oeps-tech/peripheral.harp-to-onix/Assets/harp timestmap bus to SMA.jpg

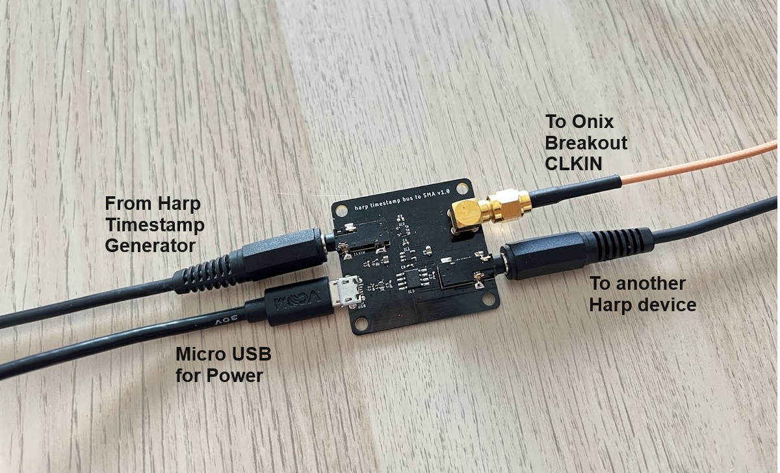
Assets/harp timestmap bus to SMA.jpg
