oeps-tech/peripheral.harp-to-onix/harp to ONIX converter BOM.xlsx

OEPS PN | Schematic Name | Qtty. | Description | Type | Manufacturer PN | Supplier | Supplier PN | Notes
OEPS020019 | R2 | 1 | RESISTOR: SMD 0402 100kΩ ±1% 0.100W [ERJ-2RKF1003X] [SMD] | SMD | ERJ-2RKF1003X | DigiKey | P100KLDKR-ND
OEPS010016 | C2, C3, C6, C7, C8 | 5 | CAPACITOR: SMD CER 0402 100nF 50V ±10% X7R [CGA2B3X7R1H104K050BB] [SMD] | SMD | CGA2B3X7R1H104K050BB | DigiKey | 445-6899-6-ND
OEPS010015 | C4, C5 | 2 | CAPACITOR: SMD CER 0603 10uF 16V ±20% X5R [EMK107BBJ106MA-T] [SMD] | SMD | EMK107BBJ106MA-T | DigiKey | 587-3238-6-ND
OEPS020026 | R1 | 1 | RESISTOR: SMD 0402 1MΩ ±1% 0.063W [CRCW04021M00FKED] [SMD] | SMD | CRCW04021M00FKED | DigiKey | 541-1.00MLDKR-ND
OEPS010017 | C1 | 1 | CAPACITOR: SMD CER 0402 4.7nF 100V ±10% X7R [885012205084] [SMD] | SMD | 885012205084 | DigiKey | 732-12234-6-ND
OEPS040003 | L1 | 1 | INDUCTOR: FERRITE BEAD SMD 40Ω 2A 50mΩ [MI0805K400R-10] [0805] | SMD | MI0805K400R-10 | DigiKey | 240-2389-6-ND
OEPS070061 | X1 | 1 | CONNECTOR: SMA JACK 50ohm R/A [PCB.SMAFRA.HT] [TH] | TH | PCB.SMAFRA.HT | DigiKey | 931-1361-ND
OEPS070025 | CLKIN, CLKOUT | 2 | CONNECTOR: 3.5MM JACK STEREO 90º [35RASMT2BHNTRX] [SMD] | SMD | 35RASMT2BHNTRX | DigiKey | SC1489-6-ND
OEPS080016 | IC1 | 1 | IC: LDO 3.3V 250mA [LP5907MFX-3.3/NOPB] [SOT-23-5] | SMD | LP5907MFX-3.3/NOPB | DigiKey | 296-38557-6-ND
OEPS080030 | IC3 | 1 | IC: DIGITAL ISOLATOR 1WAY [SI8610EC-B-ISR] [8-SOIC] | SMD | SI8610EC-B-ISR | DigiKey | 336-4930-6-ND
OEPS080029 | IC2 | 1 | IC: BUFFER NON-INVERT 1CH 3-STATE [SN74LVC1G125DBVT] [SOT-23-5] | SMD | SN74LVC1G125DBVT | DigiKey | 296-26595-6-ND
OEPS070062 | USB | 1 | CONNECTOR: USB 2.0 MICRO B R/A [ZX62D-B-5P8(30)] [SMD/TH] | SMD/TH | ZX62D-B-5P8(30) | DigiKey | H125272DKR-ND
