oeps-tech/peripheral.harp-to-onix/harp to ONIX converter PCB.pdf

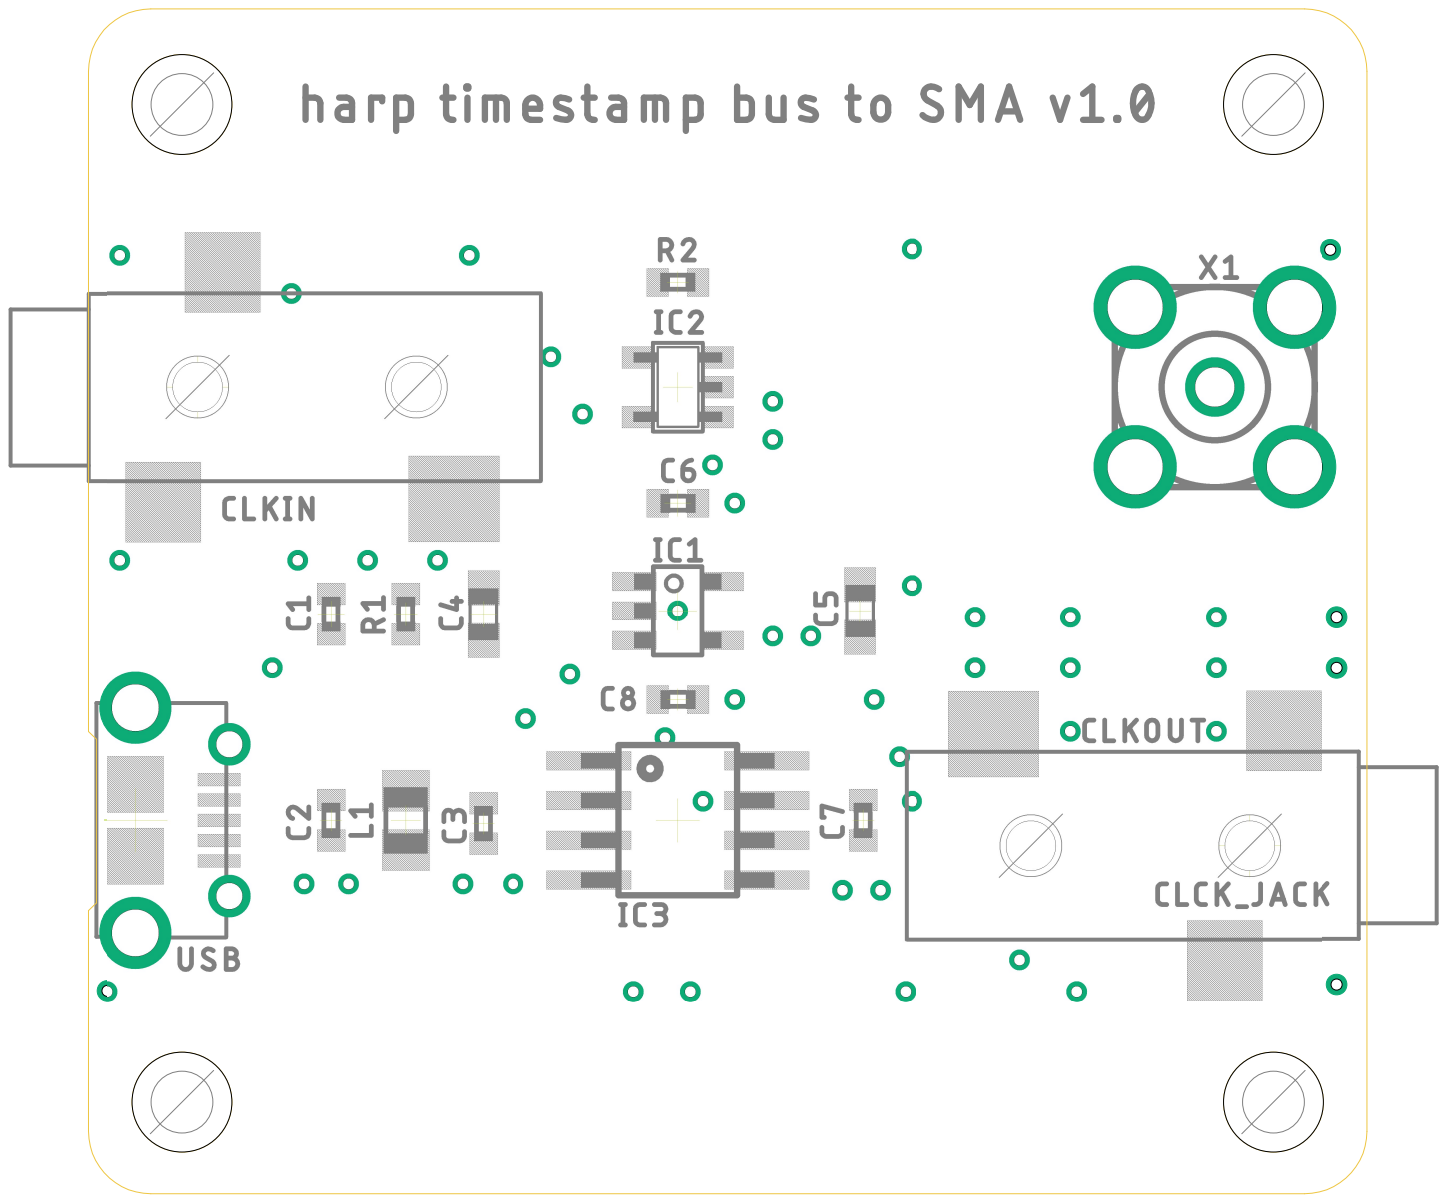
[picture p2: page 1]
