oeps-tech/peripheral.harp-to-onix/harp to ONIX converter Sch.pdf

# 1USB

A

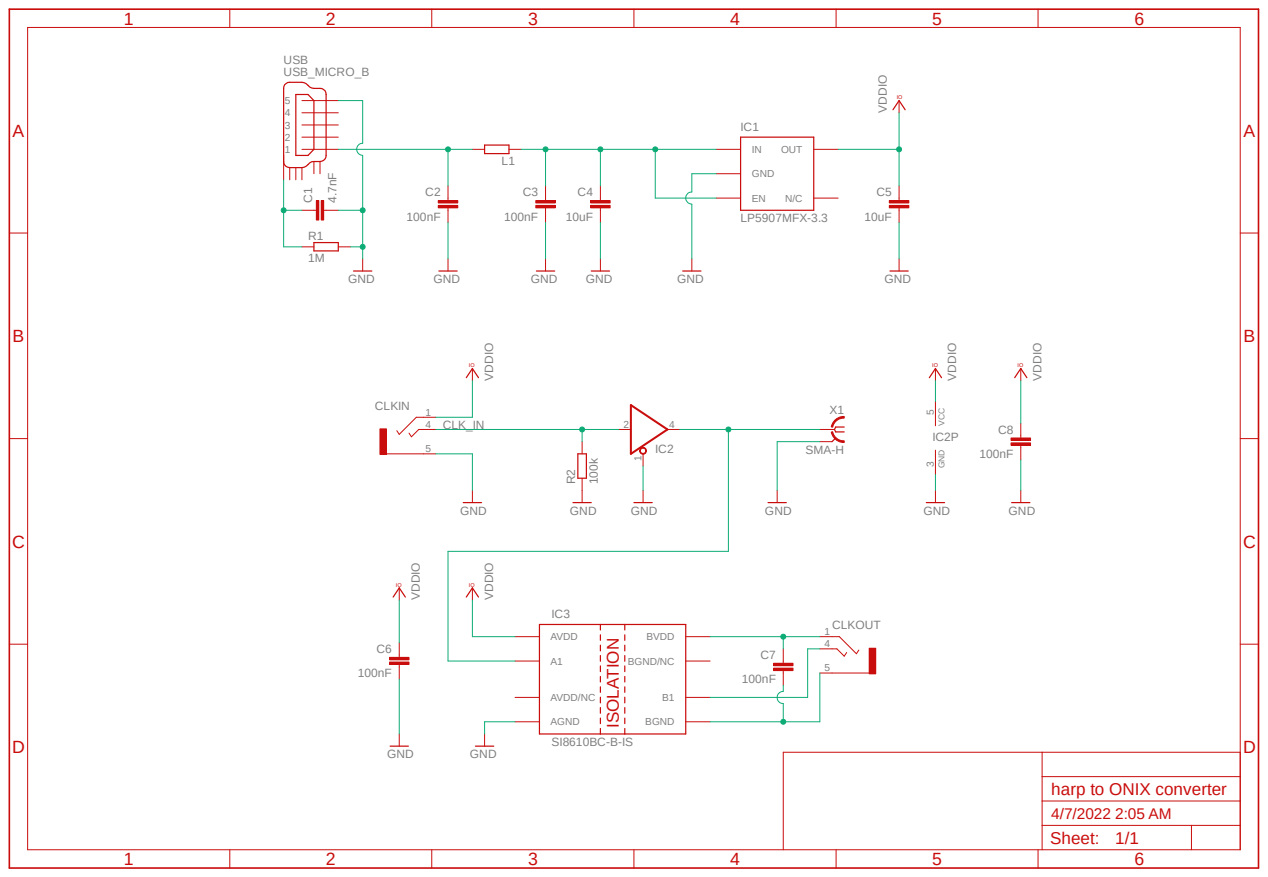
[picture p3: page 1]

harp to ONIX converter
Sheet:
