oeps-tech/peripheral.harp-to-onix/harp to ONIX converter.brd

## EAGLE design harp to ONIX converter.brd (2023-09-25)

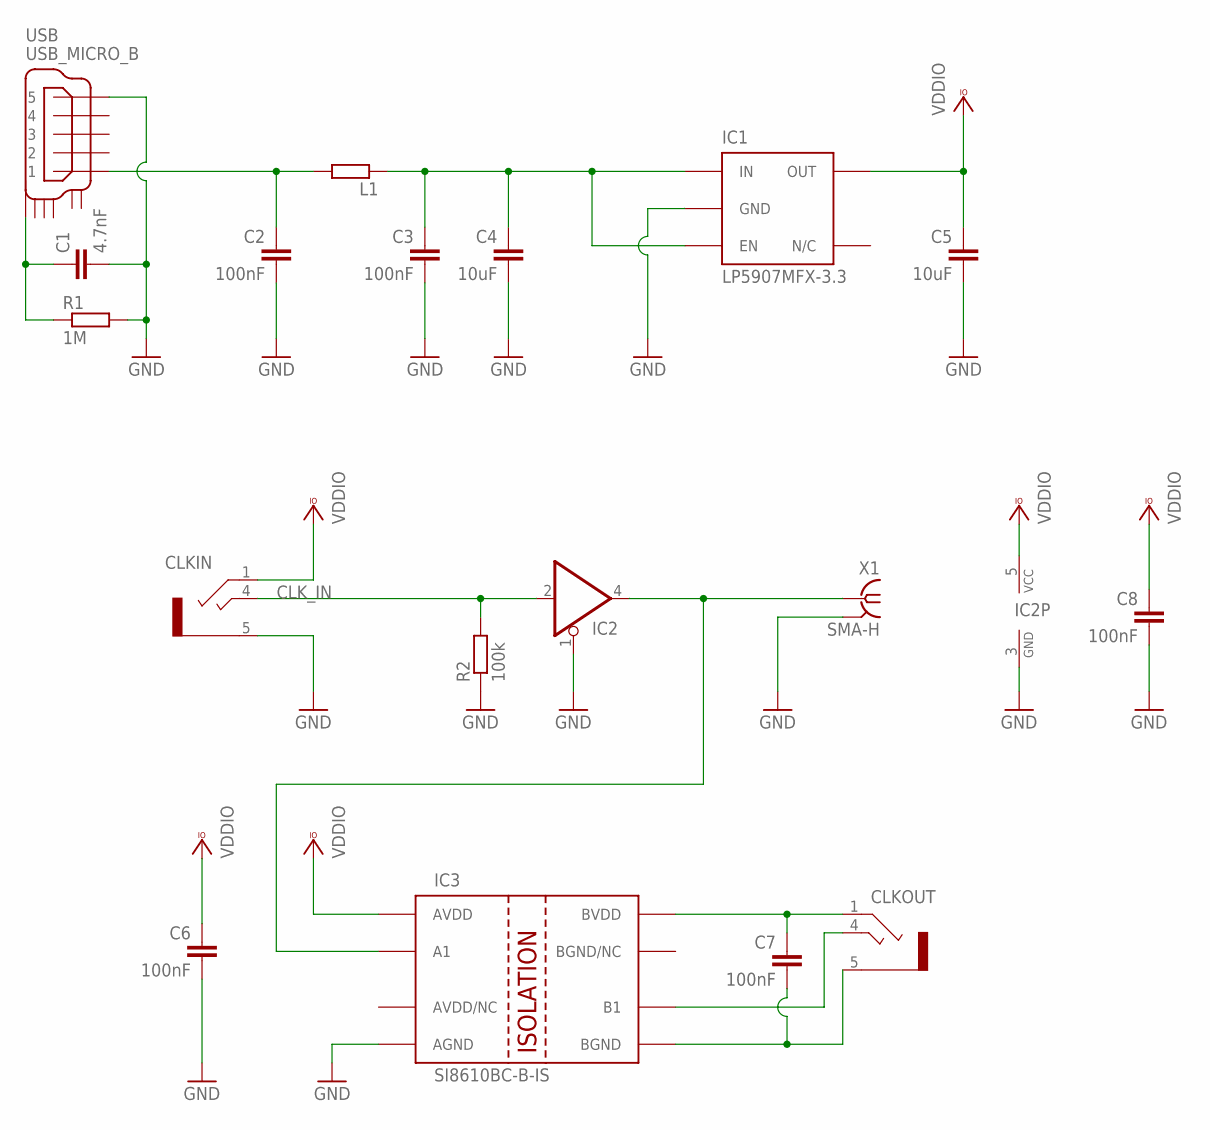
[picture p4: schematic harp to ONIX converter.sch]

Parts:
C1: 4.7nF; C0402
C2, C3, C6, C8: 100nF; C0402
C4, C5: 10uF; C0603
C7: 100nF; C0402; MPN MC0402B104K160CT
CLKIN: STEREO_JACK; 35RASMT2BHNTRX
CLKOUT: CLCK_JACK; 35RASMT2BHNTRX; MPN 35RASMT2BHNTRX
IC1: LP5907MFX-3.3; TSOT23-5
IC2: 74AHC1G125DBV; SOT23-5
IC3: SI8610BC-B-IS; SO-08; MPN SI8610EC-B-IS
L1: ???; R0805
R1: 1M; R0402
R2: 100k; R0402
USB: USB_MICRO_B; ZX62D-B-5P8
X1: SMA-H; BU-SMA-V

Connections:
5V_RAW: C3.1, C4.1, IC1.1 (IN), IC1.3 (EN), L1.1
CLK_IN: CLKIN.4, IC2.2 (I), R2.2
GND: C1.2, C2.2, C3.2, C4.2, C5.2, C6.2, C8.2, CLKIN.5, IC1.2 (GND), IC2.1 (OE), IC2.3 (GND), IC3.4 (AGND), R1.2, R2.1, USB.P$5 (5), X1.2, X1.3 (2), X1.4 (2), X1.5 (2)
GND_ISO: C7.2, CLKOUT.5, IC3.5 (BGND)
unnamed: IC2.4 (O), IC3.2 (A1), X1.1
unnamed: CLKOUT.4, IC3.6 (B1)
unnamed: C7.1, CLKOUT.1, IC3.8 (BVDD)
unnamed: C2.1, L1.2, USB.P$1 (1)
unnamed: C1.1, R1.1, USB.SHIELD_4
VCCIO: C5.1, C6.1, C8.1, CLKIN.1, IC1.5 (OUT), IC2.5 (VCC), IC3.1 (AVDD)

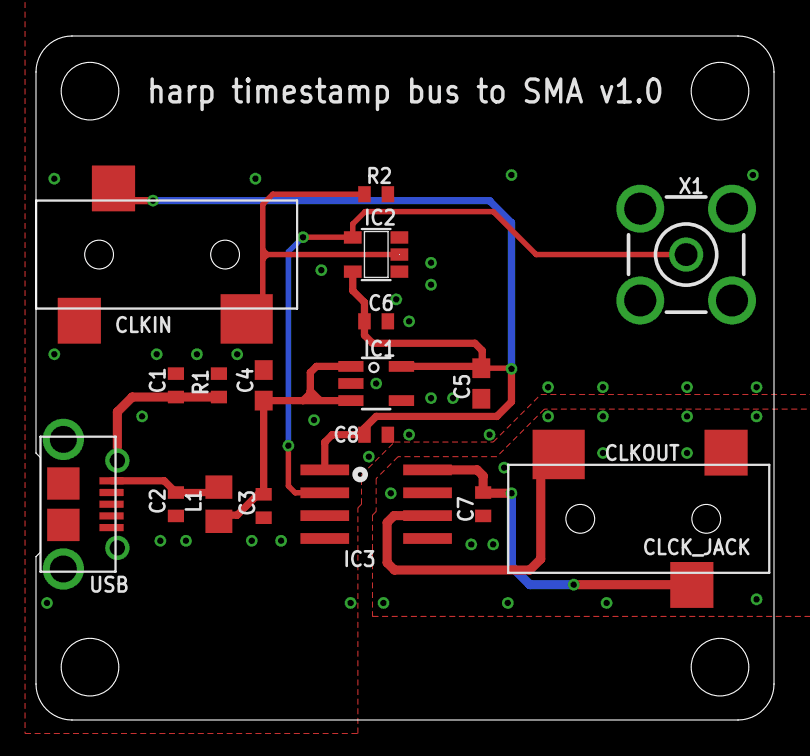
[picture p5: board harp to ONIX converter.brd from above]

Board: 2 copper layers, 41.0 x 38.0 mm, 18 parts (0 on the bottom side), 10 nets.
