oeps-tech/peripheral.harp-to-onix/(commit log)

2023-09-25 Added PCB files.
    [harp to ONIX converter.brd, harp to ONIX converter.sch]
2023-09-25 Added BOM.
    [harp to ONIX converter BOM.xlsx]
2023-09-28 Replaced some BOM items with available components.
    [harp to ONIX converter BOM.xlsx]
